tk70/BLDC/(threads)

Thread 1 (2018-04-29):

modular ESC

mkeyno, 2018-04-29:
Hi, sorry to open ticket for my question , actually I intend to made modular ESC in way that controller + gate driver is separated from Mosfets pcb , hence I could increase module ampere by adding parallel Mosfet in the Mosfets pcb, I really appreciated to have your advise or if you know open HW/SW sources let me know
