tk70/BLDC/pcb/n11e/bldc.brd

## EAGLE design pcb/n11e/bldc.brd (2014-12-06)

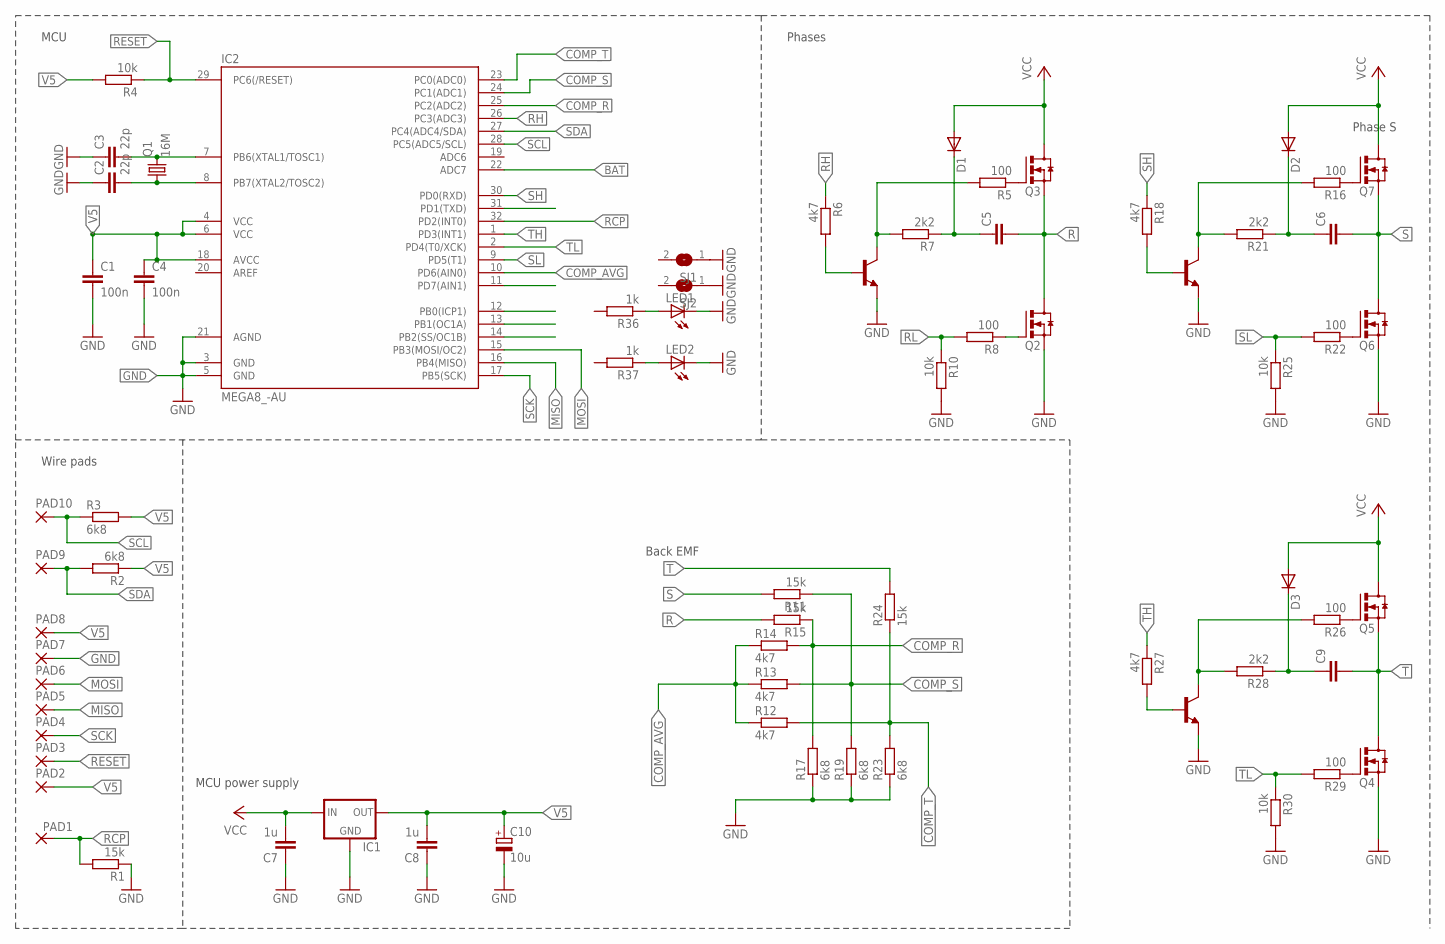
[picture p1: schematic bldc.sch]

Parts:
C1, C4: 100n; C0805K
C2, C3: 22p; C0805K
C5, C6, C9: C-EUC1206K; C1206K
C7, C8: 1u; C0805K
C10: 10u; E2,5RE
D1, D2, D3: 1N4148SOD-80; C1206K
IC1: LM1117TO252; TO252
IC2: MEGA8_-AU; TQFP32-08
LED1, LED2: LEDCHIPLED_0805; CHIPLED_0805
PAD1, PAD2, PAD3, PAD4, PAD5, PAD6, PAD7, PAD8, PAD9, PAD10: WIREPADSMD1,27-254; SMD1,27-2,54
Q1: 16M; SM49
Q2, Q3, Q4, Q5, Q6, Q7: IRFR1205; D-PAK_TO252AA
R1, R11, R24: 15k; R0603
R2, R3, R17, R19, R23: 6k8; R0603
R4, R10, R25, R30: 10k; R0603
R5, R8, R16, R22, R26, R29: 100; R0603
R6, R12, R13, R14, R18, R27: 4k7; R0603
R7, R21, R28: 2k2; R0603
R15: 15k; R0805
R36, R37: 1k; R0603
SJ1, SJ2: SJ
T1, T2, T3: BC847; SOT23

Connections:
BAT: IC2.22 (ADC7)
COMP_AVG: IC2.10 (PD6(AIN0)), R12.1, R13.1, R14.1
COMP_R: IC2.25 (PC2(ADC2)), R14.2, R15.1, R17.2
COMP_S: IC2.24 (PC1(ADC1)), R11.1, R13.2, R19.2
COMP_T: IC2.23 (PC0(ADC0)), R12.2, R23.2, R24.1
GND: C1.2, C2.1, C3.1, C4.2, C7.1, C8.1, C10.-, IC1.1 (GND), IC2.3 (GND), IC2.5 (GND), IC2.21 (AGND), LED1.C, LED2.C, PAD7.1, Q2.3 (S), Q4.3 (S), Q6.3 (S), R1.1, R10.2, R17.1, R19.1, R23.1, R25.2, R30.2, SJ1.1, SJ2.1, T1.2 (E), T2.2 (E), T3.2 (E)
MISO: IC2.16 (PB4(MISO)), PAD5.1
MOSI: IC2.15 (PB3(MOSI/OC2)), PAD6.1
unnamed: R6.2, T1.1 (B)
unnamed: C5.1, D1.2 (C), R7.1
unnamed: Q3.1 (G), R5.1
unnamed: R5.2, R7.2, T1.3 (C)
unnamed: Q6.1 (G), R22.1
unnamed: R18.2, T2.1 (B)
unnamed: C6.1, D2.2 (C), R21.1
unnamed: Q4.1 (G), R29.1
unnamed: Q2.1 (G), R8.1
unnamed: Q7.1 (G), R16.1
unnamed: R16.2, R21.2, T2.3 (C)
unnamed: R27.2, T3.1 (B)
unnamed: C9.1, D3.2 (C), R28.1
unnamed: R26.2, R28.2, T3.3 (C)
unnamed: Q5.1 (G), R26.1
unnamed: C2.2, IC2.8 (PB7(XTAL2/TOSC2)), Q1.1
unnamed: C3.2, IC2.7 (PB6(XTAL1/TOSC1)), Q1.2
unnamed: LED2.A, R37.1
unnamed: LED1.A, R36.1
R: C5.2, Q2.4 (D), Q3.3 (S), R15.2
RCP: IC2.32 (PD2(INT0)), PAD1.1, R1.2
RESET: IC2.29 (PC6(/RESET)), PAD3.1, R4.1
RH: IC2.26 (PC3(ADC3)), R6.1
RL: R8.2, R10.1
S: C6.2, Q6.4 (D), Q7.3 (S), R11.2
SCK: IC2.17 (PB5(SCK)), PAD4.1
SCL: IC2.28 (PC5(ADC5/SCL)), PAD10.1, R3.1
SDA: IC2.27 (PC4(ADC4/SDA)), PAD9.1, R2.2
SH: IC2.30 (PD0(RXD)), R18.1
SL: IC2.9 (PD5(T1)), R22.2, R25.1
T: C9.2, Q4.4 (D), Q5.3 (S), R24.2
TH: IC2.1 (PD3(INT1)), R27.1
TL: IC2.2 (PD4(T0/XCK)), R29.2, R30.1
V5: C1.1, C4.1, C8.2, C10.+, IC1.3 (OUT), IC2.4 (VCC), IC2.6 (VCC), IC2.18 (AVCC), PAD2.1, PAD8.1, R2.1, R3.2, R4.2
VCC: C7.2, D1.1 (A), D2.1 (A), D3.1 (A), IC1.2 (IN), Q3.4 (D), Q5.4 (D), Q7.4 (D)

Notes on the sheet:
Back EMF
MCU power supply
Phase S
Phases
MCU
Wire pads

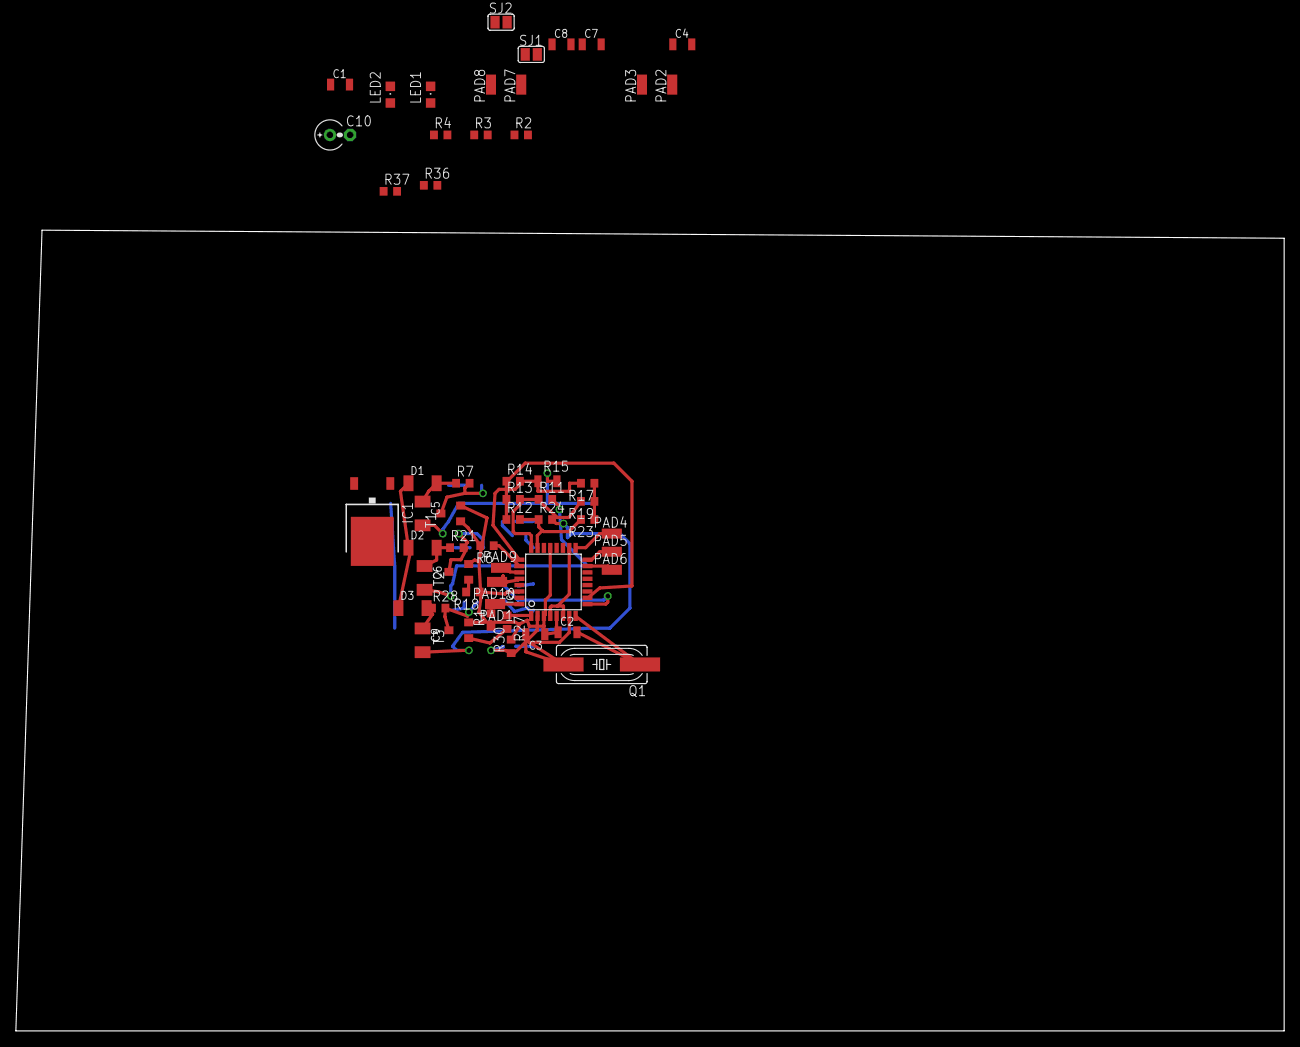
[picture p2: board pcb/n11e/bldc.brd from above]

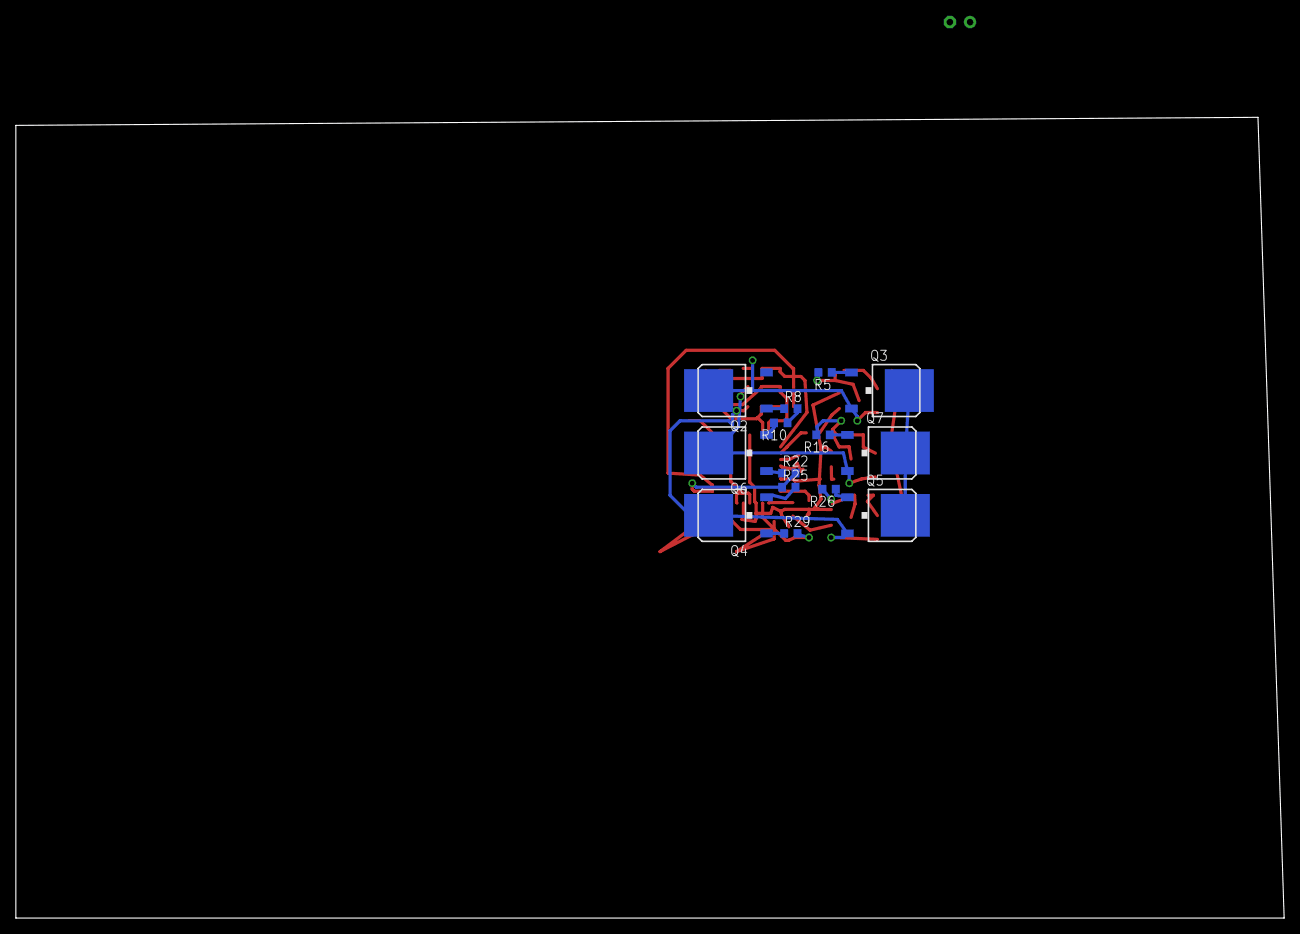
[picture p3: board pcb/n11e/bldc.brd from below]

Board: 2 copper layers, 160.0 x 101.0 mm, 69 parts (14 on the bottom side), 42 nets.
