tk70/BLDC/pcb/n11c/bldc.brd

## EAGLE design pcb/n11c/bldc.brd (2014-09-12, an earlier design)

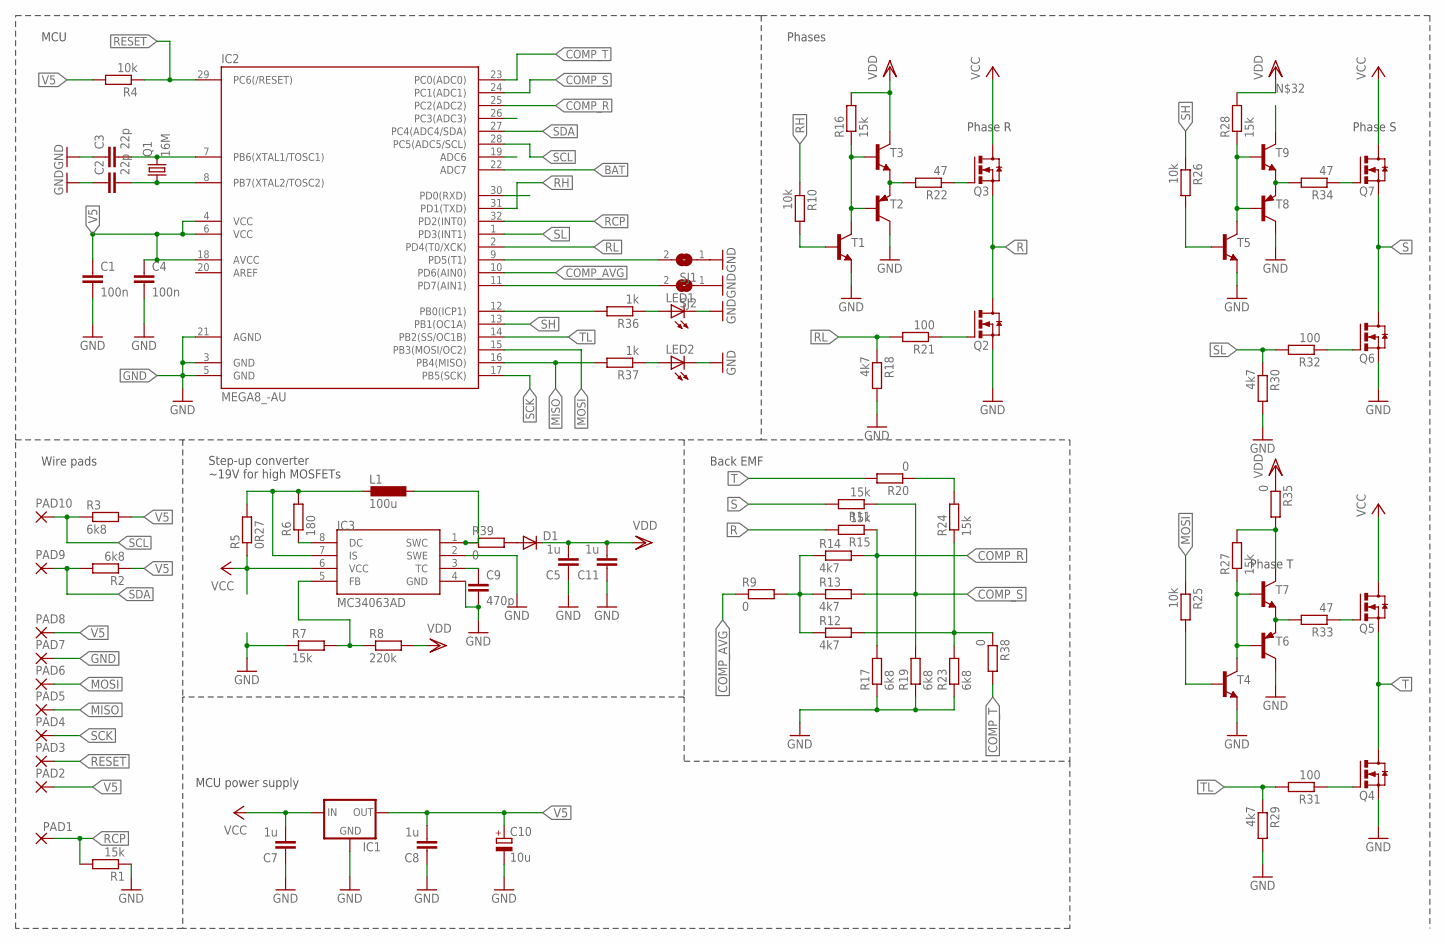
[picture p4: schematic bldc.sch]

Parts:
C1, C4: 100n; C0805K
C2, C3: 22p; C0805K
C5, C7, C8, C11: 1u; C0805K
C9: 470p; C0805K
C10: 10u; E2,5RE
D1: DIODE-SOD80C; SOD80C
IC1: LM1117TO252; TO252
IC2: MEGA8_-AU; TQFP32-08
IC3: MC34063AD; SOIC8
L1: 100u; 0204/7
LED1, LED2: LEDCHIPLED_0805; CHIPLED_0805
PAD1, PAD2, PAD3, PAD4, PAD5, PAD6, PAD7, PAD8, PAD9, PAD10: WIREPADSMD1,27-254; SMD1,27-2,54
Q1: 16M; SM49
Q2, Q3, Q4, Q5, Q6, Q7: IRFR1205; D-PAK_TO252AA
R1, R7, R11, R15, R16, R24, R27, R28: 15k; R0805
R2, R3, R17, R19, R23: 6k8; R0805
R4, R10, R25, R26: 10k; R0805
R5: 0R27; R0805
R6: 180; R0805
R8: 220k; R0805
R9, R38, R39: 0; R0805
R12, R13, R14, R18, R29, R30: 4k7; R0805
R20, R35: 0; R1206
R21, R31, R32: 100; R0805
R22, R33, R34: 47; R0805
R36, R37: 1k; R0805
SJ1, SJ2: SJ
T1, T3, T4, T5, T7, T9: BC847; SOT23
T2, T6, T8: BC807-16-PNP-SOT23-BEC; SOT23-BEC

Connections:
BAT: IC2.22 (ADC7)
COMP_AVG: IC2.10 (PD6(AIN0)), R9.1
COMP_R: IC2.25 (PC2(ADC2)), R14.2, R15.1, R17.2
COMP_S: IC2.24 (PC1(ADC1)), R11.1, R13.2, R19.2
COMP_T: IC2.23 (PC0(ADC0)), R38.2
GND: C1.2, C2.1, C3.1, C4.2, C5.1, C7.1, C8.1, C9.2, C10.-, C11.1, IC1.1 (GND), IC2.3 (GND), IC2.5 (GND), IC2.21 (AGND), IC3.2 (SWE), IC3.4 (GND), LED1.C, LED2.C, PAD7.1, Q2.3 (S), Q4.3 (S), Q6.3 (S), R1.1, R7.1, R17.1, R18.2, R19.1, R23.1, R29.2, R30.2, SJ1.1, SJ2.1, T1.2 (E), T2.C, T4.2 (E), T5.2 (E), T6.C, T8.C
MISO: IC2.16 (PB4(MISO)), PAD5.1, R37.2
MOSI: IC2.15 (PB3(MOSI/OC2)), PAD6.1, R25.1
unnamed: R10.2, T1.1 (B)
unnamed: R9.2, R12.1, R13.1, R14.1
unnamed: R16.1, T1.3 (C), T2.B, T3.1 (B)
unnamed: Q3.1 (G), R22.1
unnamed: R22.2, T2.E, T3.2 (E)
unnamed: Q4.1 (G), R31.1
unnamed: Q2.1 (G), R21.1
unnamed: Q6.1 (G), R32.1
unnamed: IC3.5 (FB), R7.2, R8.1
unnamed: IC3.8 (DC), R6.1
unnamed: IC3.1 (SWC), L1.1, R39.1
unnamed: IC3.7 (IS), L1.2, R5.2, R6.2
unnamed: R28.1, T5.3 (C), T8.B, T9.1 (B)
unnamed: C2.2, IC2.8 (PB7(XTAL2/TOSC2)), Q1.1
unnamed: C3.2, IC2.7 (PB6(XTAL1/TOSC1)), Q1.2
unnamed: Q7.1 (G), R34.1
unnamed: R34.2, T8.E, T9.2 (E)
unnamed: R26.2, T5.1 (B)
unnamed: Q5.1 (G), R33.1
unnamed: R20.1, R24.2
unnamed: R27.1, T4.3 (C), T6.B, T7.1 (B)
unnamed: R33.2, T6.E, T7.2 (E)
unnamed: R27.2, R35.2, T7.3 (C), T9.3 (C)
unnamed: IC2.12 (PB0(ICP1)), R36.2
unnamed: IC2.11 (PD7(AIN1)), SJ2.2
unnamed: R25.2, T4.1 (B)
unnamed: IC2.9 (PD5(T1)), SJ1.2
unnamed: LED2.A, R37.1
unnamed: LED1.A, R36.1
unnamed: R12.2, R23.2, R24.1, R38.1
unnamed: C9.1, IC3.3 (TC)
unnamed: D1.A, R39.2
R: Q2.4 (D), Q3.3 (S), R15.2
RCP: IC2.32 (PD2(INT0)), PAD1.1, R1.2
RESET: IC2.29 (PC6(/RESET)), PAD3.1, R4.1
RH: IC2.31 (PD1(TXD)), R10.1
RL: IC2.2 (PD4(T0/XCK)), R18.1, R21.2
S: Q6.4 (D), Q7.3 (S), R11.2
SCK: IC2.17 (PB5(SCK)), PAD4.1
SCL: IC2.28 (PC5(ADC5/SCL)), PAD10.1, R3.1
SDA: IC2.27 (PC4(ADC4/SDA)), PAD9.1, R2.2
SH: IC2.13 (PB1(OC1A)), R26.1
SL: IC2.1 (PD3(INT1)), R30.1, R32.2
T: Q4.4 (D), Q5.3 (S), R20.2
TL: IC2.14 (PB2(SS/OC1B)), R29.1, R31.2
V5: C1.1, C4.1, C8.2, C10.+, IC1.3 (OUT), IC2.4 (VCC), IC2.6 (VCC), IC2.18 (AVCC), PAD2.1, PAD8.1, R2.1, R3.2, R4.2
VCC: C7.2, IC1.2 (IN), IC3.6 (VCC), Q3.4 (D), Q5.4 (D), Q7.4 (D), R5.1
VDD: C5.2, C11.2, D1.C, R8.2, R16.2, R28.2, R35.1, T3.3 (C)

Notes on the sheet:
Phase R
Step-up converter ~19V for high MOSFETs
Back EMF
MCU power supply
Phase S
Phase T
Phases
MCU
Wire pads

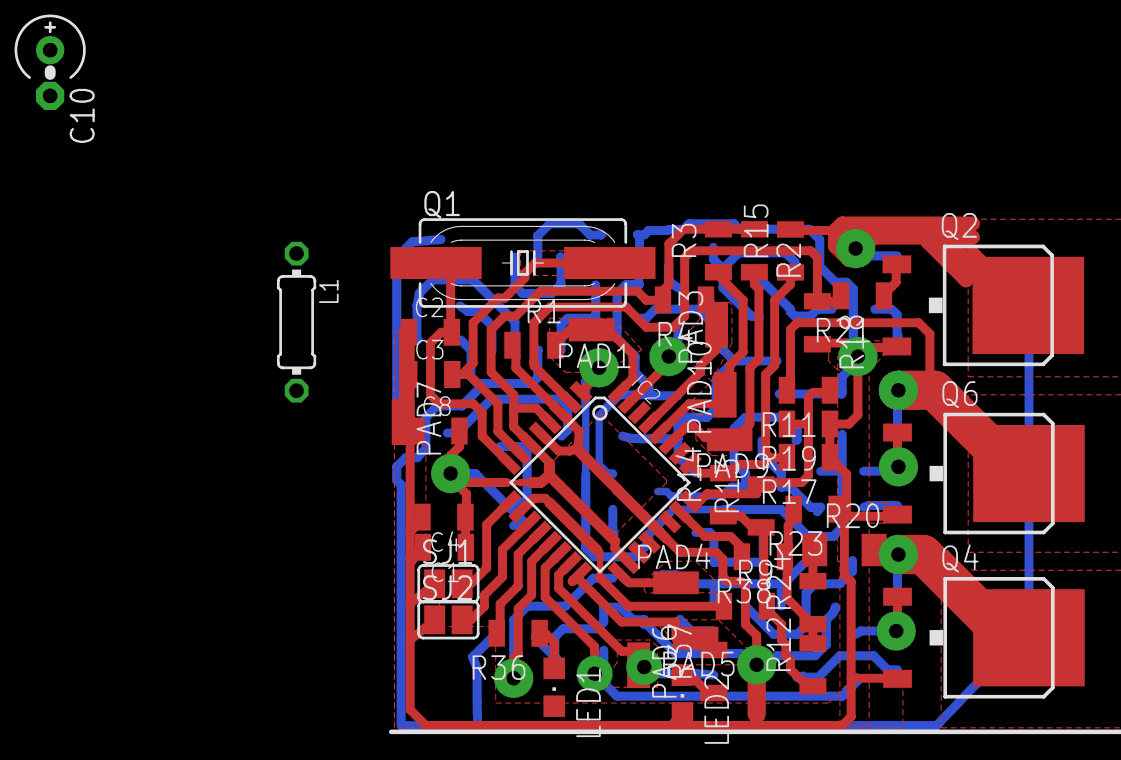
[picture p5: board pcb/n11c/bldc.brd from above]

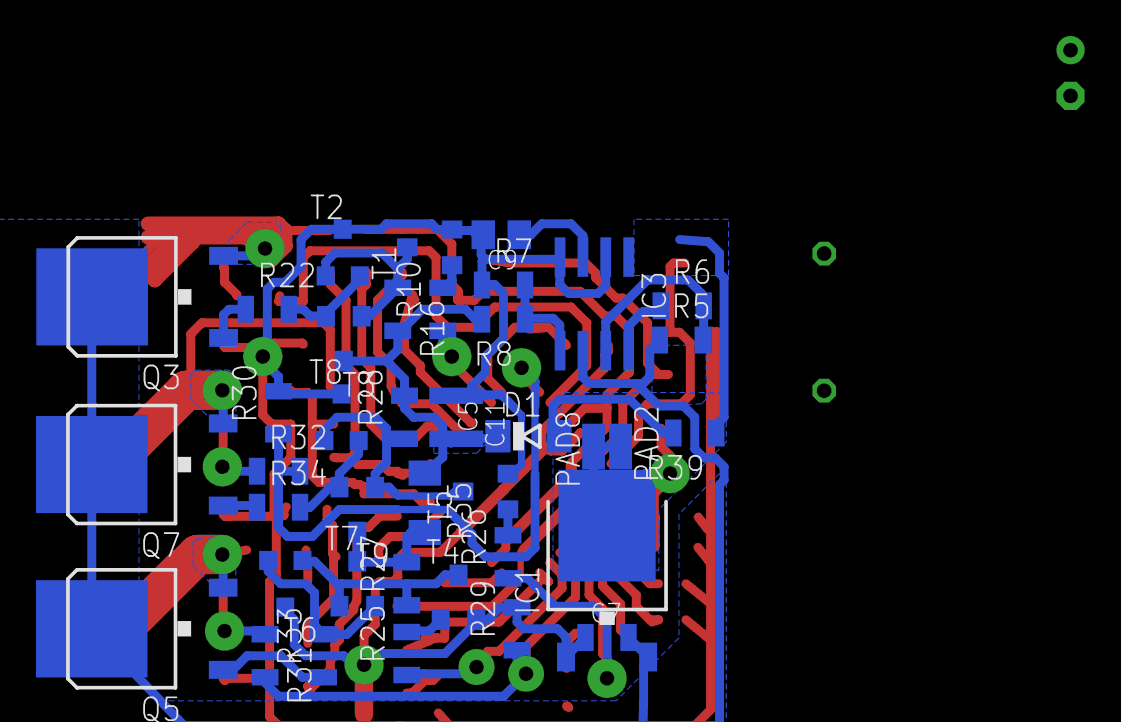
[picture p6: board pcb/n11c/bldc.brd from below]

Board: 3 copper layers, 84 parts (40 on the bottom side), 55 nets.
