tk70/BLDC/(commit log)

2013-10-05 led stuff, beeps
    the timer freezes sometiems if used after power on
2013-11-13 started i2c implementation
2013-11-19 fixed sync loss on low rpm
    [bldc.asm]
2013-11-27 working on i2c protocol
2014-02-27 support for inverting pins
    [bldc.asm]
2014-03-12 speed-power limit, governor
2014-06-13 moved sdm to timer2, throttle rising speed limited
2014-06-15 governor: added anti-windup, error dead zone
    [bldc.asm]
2014-09-12 Added PCB eagle files
    [bldc.brd, bldc.sch]
2014-12-06 new board
    [bldc.brd, bldc.sch]
